nguyentanhuy698-maker/bai-giu-xe-thong-minh/docs/rap-cat-1-1-A4.pdf

## HƯỚNG DẪN DÙNG RẬP

In khổ A4, tỉ lệ 100 % (Actual size), tắt "Fit to page" / "Vừa trang"

Tờ 1/10

Rập 1:1 · Bãi giữ xe máy thông minh · ĐA2

## 50 mm

KIỂM TRA: khung bên phải dài đúng 50 mm →

Sai lệch quá 0,5 mm: in lại ở 100 %, tắt "Vừa trang"

Nét liền đậm: cắt · Chữ thập: tâm khoan (chấm dùi trước) · Nét gạch: chỉ đánh dấu, không cắt · Kích thước ghi bằng mm

## CÁC BƯỚC

1. In tất cả các tờ trên giấy A4 ở tỉ lệ 100 %. Đo khung kiểm tra ở góc dưới mỗi tờ: phải đúng
50 mm.
2. Cắt rời từng chi tiết, chừa khoảng 3 mm ngoài nét cắt.
3. Dán rập lên mặt mica còn giấy bảo vệ (hoặc lên Formex) bằng keo dán giấy dạng thỏi hoặc băng keo 2 mặt mỏng.
4. Chấm dùi vào tâm chữ thập rồi mới khoan: khoan mồi Ø2, sau đó khoan đúng đường kính ghi cạnh lỗ.
5. Lỗ khoét chữ nhật (có gạch chéo): khoan 4 góc Ø3, cắt theo cạnh bằng cưa lọng hoặc dao cắt mica, giũa tới nét.
6. Cắt mica: dùng dao rạch mica rạch 5–6 lần theo nét liền, bẻ trên mép bàn. Mica trong 2 mm rạch nhẹ tay hơn.
7. Nét gạch chỉ để đánh dấu vị trí dán linh kiện, decal: không cắt.
8. Bóc rập bằng cách bóc luôn lớp giấy bảo vệ mica. Với Formex, lau keo bằng khăn ẩm.
9. Chi tiết dài hơn tờ A4 được chia nhiều tờ: chồng các dấu ghép ⊕ cùng tên lên nhau rồi dán băng keo.

## DANH SÁCH TỜ RẬP

1 | Hướng dẫn, chi tiết cắt thẳng theo kích thước
2 | Chốt: vách P1, P2, P3, P4
3 | Chốt: kính K1, K2
4 | Chốt: mái, viền biển tên, đế, quầy
5 | Tủ barie VÀO + cần barie
6 | Tủ barie RA + cần barie
7 | Hộp camera và cột camera (2 bộ)
8 | Đảo phân làn – rập khoan và vị trí dán (nửa phía đường)
9 | Đảo phân làn – rập khoan và vị trí dán (nửa phía bãi)
10 | Đế: nắp thăm, lỗ mặt sau, rãnh sườn, lỗ cột đỡ cần

## CHI TIẾT CẮT THẲNG (không cần rập, cắt theo kích thước)

Chi tiết | Kích thước | SL | Vật liệu / ghi chú
Mặt đế | 560 × 450 | 1 | Formex 5
Đáy đế | 560 × 450 | 1 | MDF 3 (khoét nắp thăm: tờ 10)
Khung trước, sau | 560 × 40 | 2 | Formex 5 (khung sau khoét lỗ: tờ 10)
Khung trái, phải | 440 × 40 | 2 | Formex 5
Sườn | 440 × 40 | 2 | Formex 5 (rãnh dây: tờ 10)
Vỉa hè trái | 90 × 330 | 2 lớp | Formex 5 + 3
Vỉa hè phải | 70 × 330 | 2 lớp | Formex 5 + 3
Đảo phân làn | 100 × 330 | 3 lớp | Formex 5 (khoan theo tờ 8, 9)
Trụ góc chốt | 4 × 4 × 98 | 4 | nhôm hộp
Ống cột camera | Ø12 × 47 | 2 | ống nhôm
Que đỡ cần | Ø5 × 64 | 2 | inox

## CHỐT – VÁCH DƯỚI (mica xám 3 mm)

P3 và P4 giống nhau. Vẽ nhìn từ mặt ngoài.

Tờ 2/10

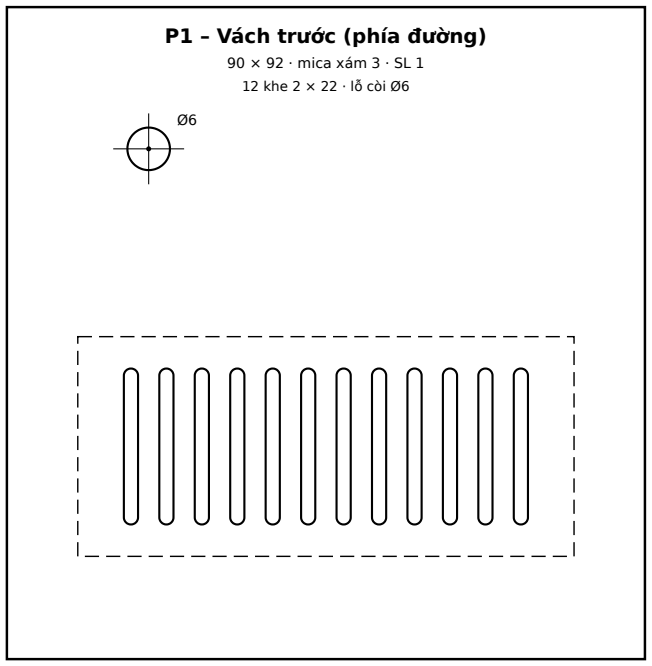
[picture p18: figure]
P1 – Vách trước (phía đường); 90 × 92 · mica xám 3 · SL 1 12 khe 2 × 22 · lỗ còi Ø6
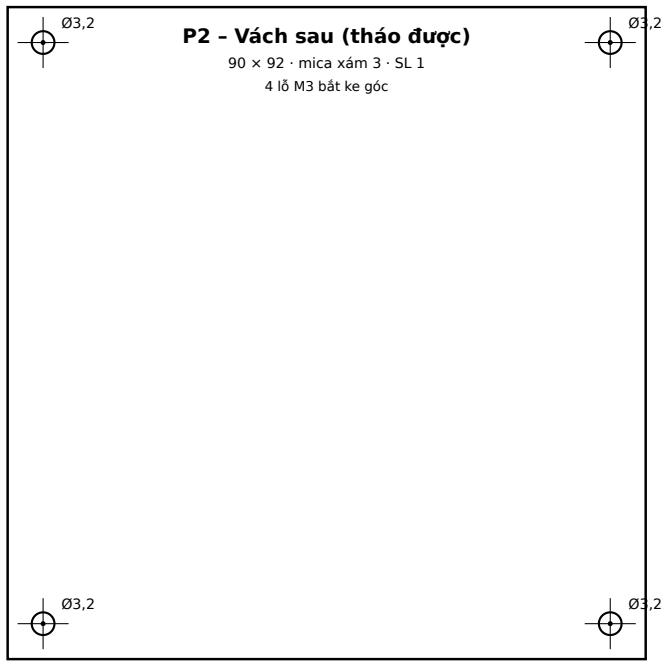
[picture p19: figure]
Ø3,2 P2 – Vách sau (tháo được); 90 × 92 · mica xám 3 · SL 1 4 lỗ M3 bắt ke góc
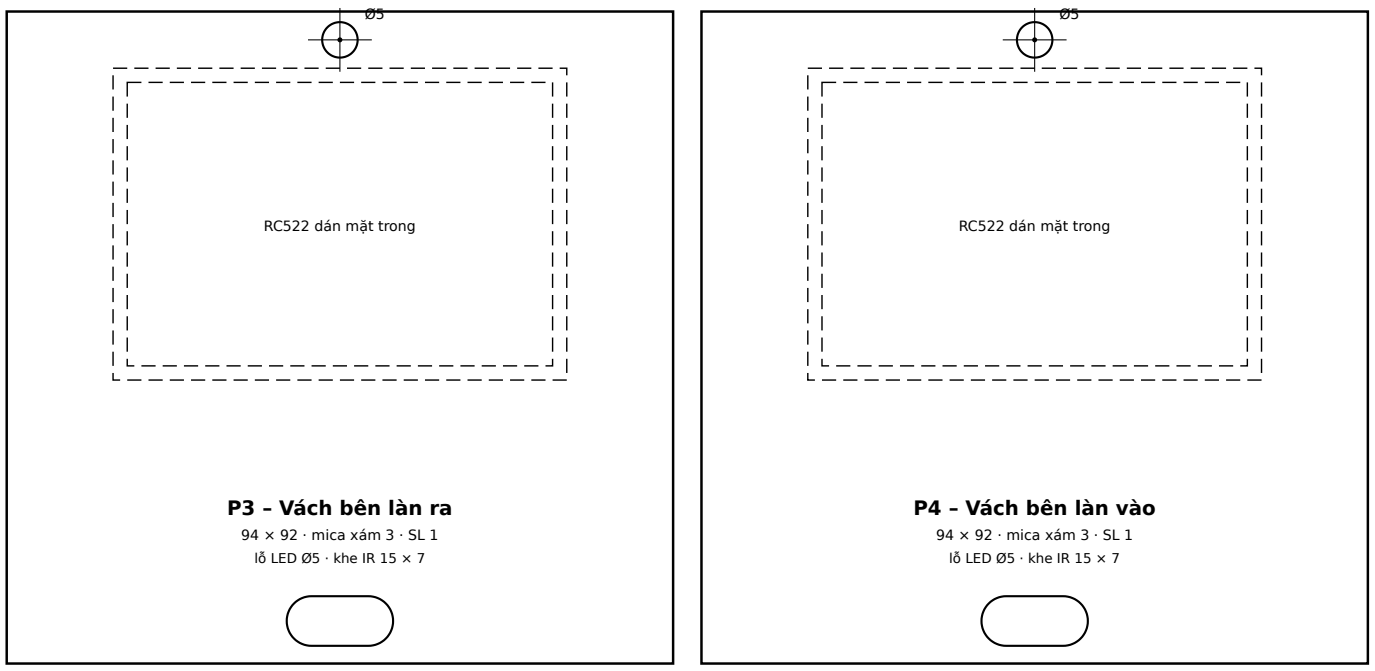
[picture p20: figure]
RC522 dán mặt trong; P3 – Vách bên làn ra; 94 × 92 · mica xám 3 · SL 1 lỗ LED Ø5 · khe IR 15 × 7; P4 – Vách bên làn vào

Mép dưới mỗi vách dán xuống đế chốt; P3, P4 kẹp giữa P1, P2 (chiều rộng 94 = 100 − 2 × 3).

Mặt quẹt thẻ: dán decal 64 × 44 lên mặt ngoài P3, P4 trùng khung nét gạch.

## CHỐT – KÍNH (mica trong 2 mm)

K1: kính trước và sau; K2: kính hai bên, chừa cửa đưa thẻ rộng 36

Tờ 3/10

K1 – Kính trước

82 × 94 · mica trong 2 · SL 1

K1 – Kính sau

82 × 94 · mica trong 2 · SL 1

K2 – Kính bên 1

28 × 94 · mica trong 2 · SL 1

K2 – Kính bên 2

28 × 94 · mica trong 2 · SL 1

K2 – Kính bên 3

28 × 94 · mica trong 2 · SL 1

K2 – Kính bên 4
28 × 94 · mica trong 2 · SL 1 | Ráp: mỗi vách bên dùng 2 tấm K2,
| cách nhau 36 (cửa đưa thẻ).
| K1, K2 dán vào 4 trụ nhôm 4 × 4.

## CHỐT – MÁI, VIỀN BIỂN TÊN, ĐẾ, QUẦY

Viền biển tên dán thành khung 108 × 118 quanh mái

Tờ 4/10

M – Mái

106 × 116 · mica xám 3 · SL 1

B1 16×118 SL 1

B1 – viền dài 118 × 16

B1 16×118 SL 1

B1 – viền dài 118 × 16

B2 16×102 SL 1

B2 – viền ngắn 102 × 16

B2 16×102 SL 1

B2 – viền ngắn 102 × 16

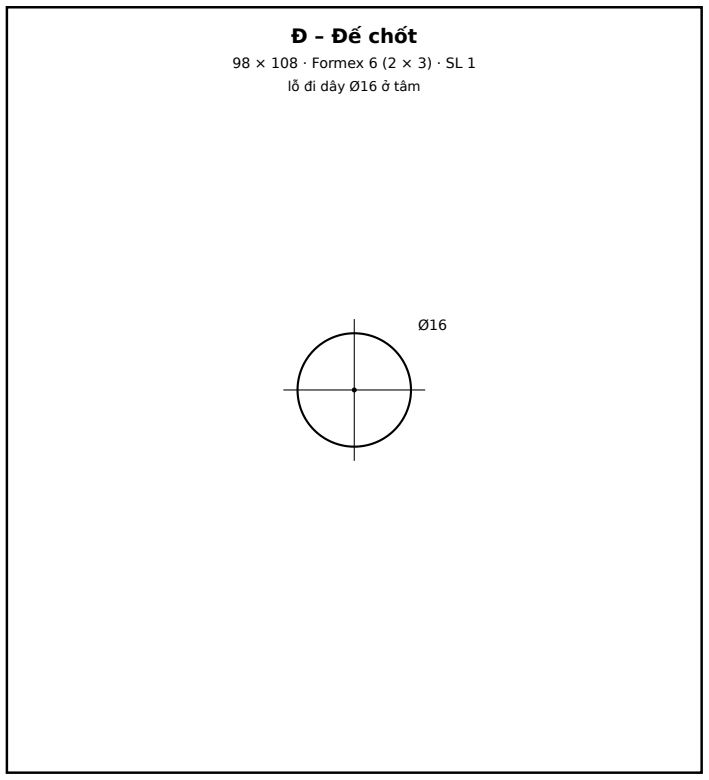
[picture p21: figure]
Đ – Đế chốt; 98 × 108 · Formex 6 (2 × 3) · SL 1 lỗ đi dây Ø16 ở tâm

Q 16×44 SL 1 | Q 16×44 SL 1

Q – Quầy 16 × 44 (2 tấm), dán ngang mép trên vách bên, giữa vách.

## TỦ BARIE VÀO + CẦN BARIE (mica vàng 3 mm, cần mica trắng 4 mm)

C1 nhìn từ mặt ngoài phía làn; đầu servo đẩy từ trong ra qua lỗ khoét

Tờ 5/10

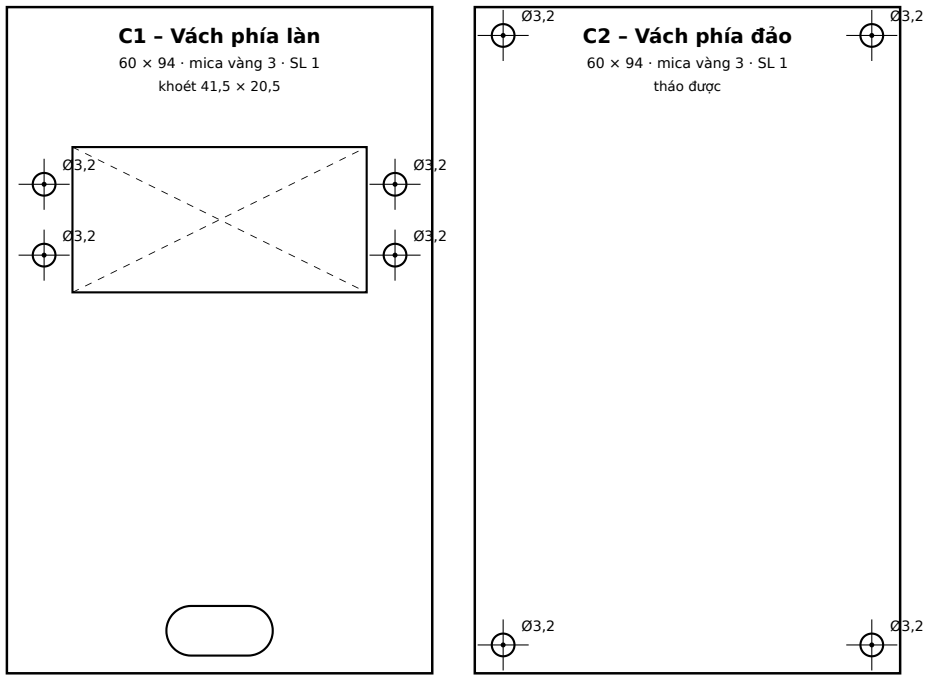
[picture p22: figure]
C1 – Vách phía làn; 60 × 94 · mica vàng 3 · SL 1 khoét 41,5 × 20,5; C2 – Vách phía đảo; 60 × 94 · mica vàng 3 · SL 1 tháo được

decal VÀO

C3 – Vách trước

44 × 94 · mica vàng 3 · SL 1

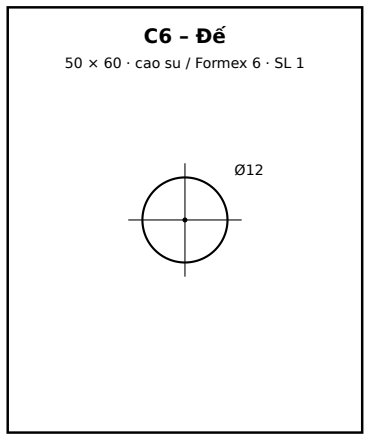
[picture p23: figure]
50 × 60 · cao su / Formex 6 · SL 1

C4 – Vách sau

44 × 94 · mica vàng 3 · SL 1

C5 – Nắp

54 × 64 · mica xám 3 · SL 1

CB – Cần barie 150 × 8 (mica trắng 4) · 2 lỗ Ø2,2 · khung gạch: decal đỏ 10 × 8

đầu cao su 8 × 10

Ngàm đỡ cần 8 × 9

rãnh 5 × 5, dày 10

## TỦ BARIE RA + CẦN BARIE (mica vàng 3 mm, cần mica trắng 4 mm)

C1 nhìn từ mặt ngoài phía làn; đầu servo đẩy từ trong ra qua lỗ khoét

Tờ 6/10

decal RA

C3 – Vách trước

44 × 94 · mica vàng 3 · SL 1

C4 – Vách sau

44 × 94 · mica vàng 3 · SL 1

C5 – Nắp

54 × 64 · mica xám 3 · SL 1

CB – Cần barie 150 × 8 (mica trắng 4) · 2 lỗ Ø2,2 · khung gạch: decal đỏ 10 × 8

đầu cao su 8 × 10

Ngàm đỡ cần 8 × 9

rãnh 5 × 5, dày 10

## HỘP CAMERA VÀ CỘT CAMERA – ĐỦ CHO 2 CỘT

Hộp: mica trắng 2 mm; H4 mica trong 2 mm; H5 mica xám 2 mm

Tờ 7/10

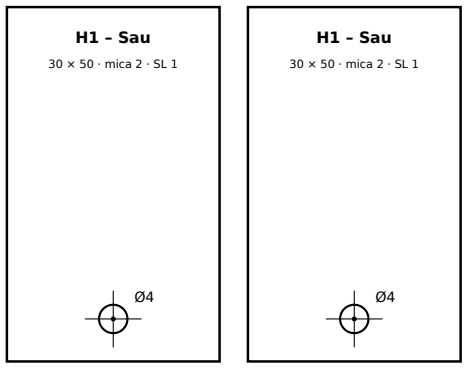
[picture p24: figure]
H1 – Sau; 30 × 50 · mica 2 · SL 1

H2 – Bên

28 × 50 · mica 2 · SL 1

H2 – Bên

28 × 50 · mica 2 · SL 1

H2 – Bên

28 × 50 · mica 2 · SL 1

H2 – Bên

28 × 50 · mica 2 · SL 1

H2: rãnh giữ bo ESP32-CAM sâu 1 (nét gạch) – khắc bằng dao, cách mép trước 6

Ø4

H3 – Đáy

30 × 26 · mica 2 · SL 1
Ø4

H3 – Đáy

30 × 26 · mica 2 · SL 1

H4 – Cửa sổ

30 × 46 · mica trong 2 · SL 1

H4 – Cửa sổ

30 × 46 · mica trong 2 · SL 1

H5 – Mái che

40 × 38 · mica xám 2 · SL 1

H5 – Mái che

40 × 38 · mica xám 2 · SL 1

Đ – Đế cột Ø20, lỗ Ø8 | Đ – Đế cột Ø20, lỗ Ø8
N 8 × 8 | N 8 × 8

N: mặt trên vát 15°

T – Tay đỡ đèn 30 × 4 × 4 (2 thanh)

THƯỚC ĐẶT GÓC CAMERA (cắt rời, đặt sát mép đảo khi dán cột)

35,8°

mép đảo, chiều xe chạy ↑

hướng ống kính

15°

phương ngang

trục ống kính chúc xuống

## ĐẢO PHÂN LÀN 100 × 330 – TỜ 1/2 (nửa phía đường)

Dán lên lớp đảo trên cùng, khoan xuyên 3 lớp đảo và mặt đế. Nét gạch: chỗ dán chốt, tủ, cột.

Tờ 8/10

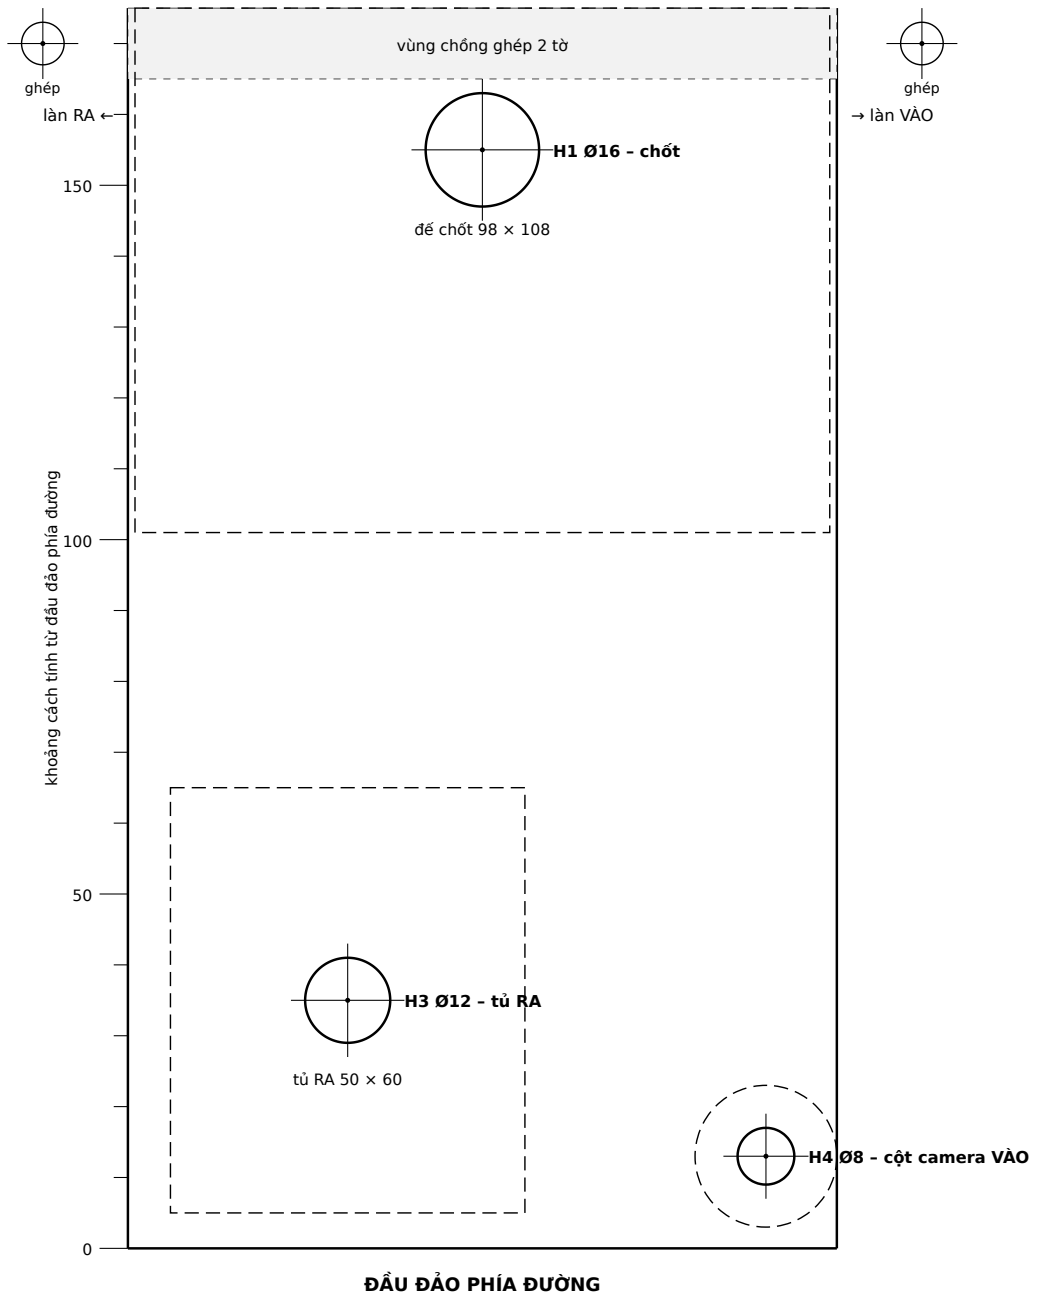
[picture p25: figure]
vùng chồng ghép 2 tờ; ghép; đế chốt 98 × 108; H1 Ø16 – chốt; H4 Ø8 – cột camera VÀO; khoảng cách tính từ đầu đảo phía đường; ĐẦU ĐẢO PHÍA ĐƯỜNG; làn RA ←; → làn VÀO

Đặt đảo lên mặt đế: mép trái cách mép đế 240, đầu đảo cách mép đế phía đường 60

## ĐẢO PHÂN LÀN 100 × 330 – TỜ 2/2 (nửa phía bãi)

Dán lên lớp đảo trên cùng, khoan xuyên 3 lớp đảo và mặt đế. Nét gạch: chỗ dán chốt, tủ, cột.

Tờ 9/10

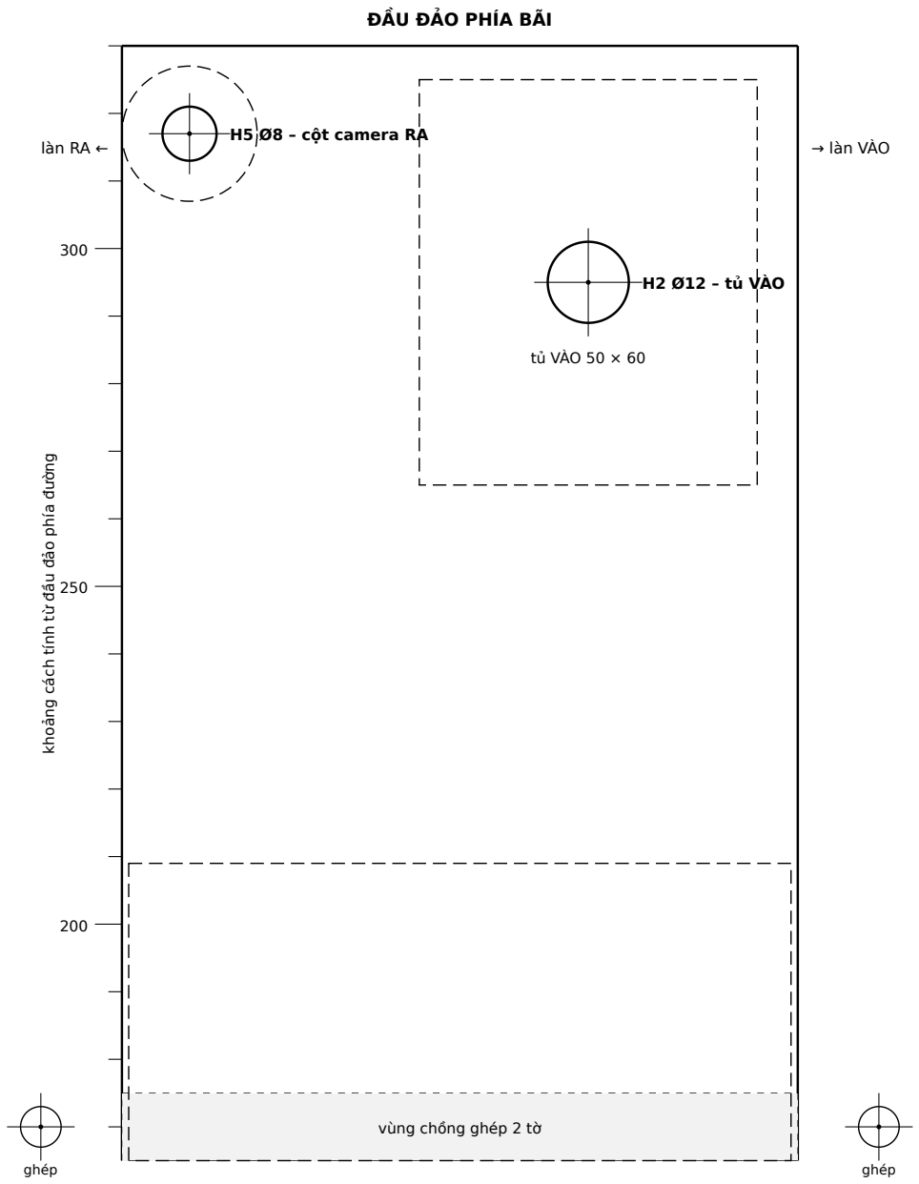
[picture p26: figure]
vùng chồng ghép 2 tờ; ghép; tủ VÀO 50 × 60; H2 Ø12 – tủ VÀO; H5 Ø8 – cột camera RA; khoảng cách tính từ đầu đảo phía đường; ĐẦU ĐẢO PHÍA BÃI; làn RA ←; → làn VÀO

ĐẾ – NẮP THĂM, LỖ MẶT SAU, RÃNH SƯỜN, LỖ CỘT ĐỠ CẦN | Tờ 10/10

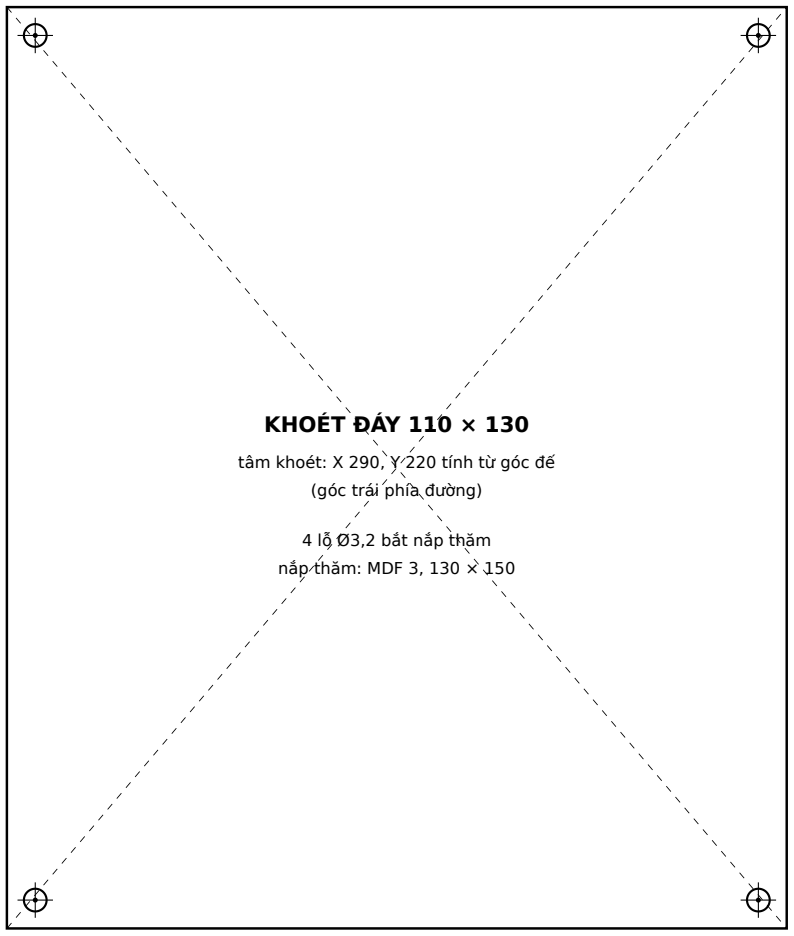
[picture p27: figure]
KHOÉT ĐÁY 110 × 130; tâm khoét: X 290, Y 220 tính từ góc đế; (góc trái phía đường); 4 lỗ Ø3,2 bắt nắp thăm; nắp thăm: MDF 3, 130 × 150
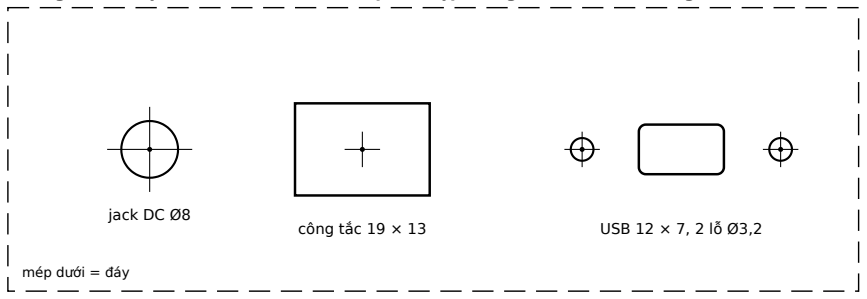
[picture p28: figure]
jack DC Ø8; công tắc 19 × 13; USB 12 × 7, 2 lỗ Ø3,2; mép dưới = đáy

Khung sau – đoạn có lỗ (dán sao cho mép trái rập trùng X = 120 của khung sau)

Rãnh dây trên sườn (4 chỗ)

khoét 24 × 15

đoạn sườn cao 40

Tâm rãnh tại Y = 120 và Y = 330 (tính từ mép đế phía đường)

Vỉa hè PHẢI – cột đỡ cần VÀO

mép vỉa hè giáp làn = cạnh trái
tâm cách cạnh 5, cách đầu phía đường 305

Ø5 sâu 8

Vỉa hè TRÁI – cột đỡ cần RA

cạnh phải giáp làn, cạnh dưới phía đường tâm cách cạnh phải 5, cách cạnh dưới 25

Ø5 sâu 8
