nguyentanhuy698-maker/bai-giu-xe-thong-minh/tools/ban-ve/img_persp.png

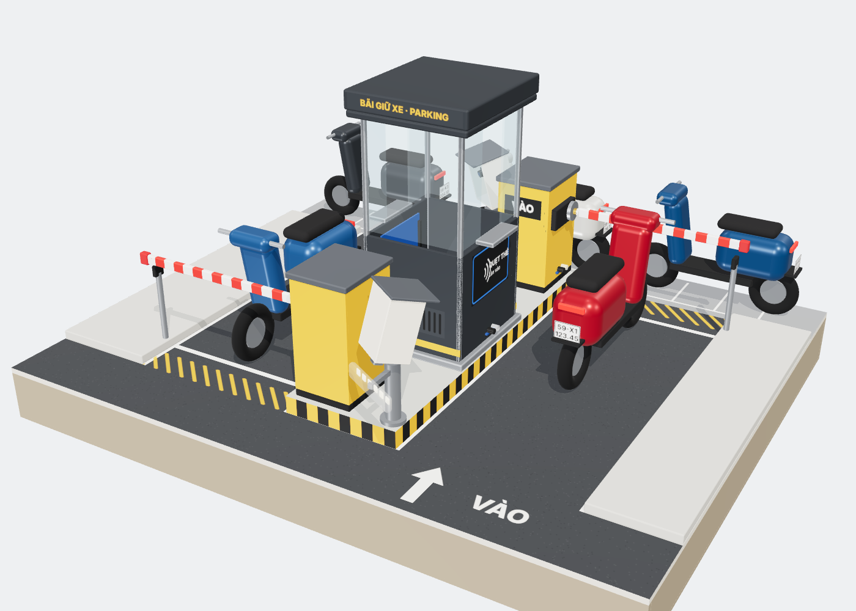
tools/ban-ve/img_persp.png
