nguyentanhuy698-maker/bai-giu-xe-thong-minh/(commit log)

2026-11-10 Thêm trang mô phỏng bãi giữ xe và phối cảnh 3D
    Claude-Session: https://claude.ai/code/session_01Y5WDavQozfoccEv6DFBwDj
2026-11-10 Thiết kế lại giao diện trang mô phỏng
    Bảng điều khiển kiểu chốt bảo vệ, sơ đồ 50 chỗ đỗ, thanh tiến trình từng bước cho mỗi làn, phím tắt V/R/T/A, bố cục cho điện thoại.
    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
2026-11-11 Thêm mô phỏng Wokwi cho trụ điều khiển 2 làn
    Firmware ESP32 dạng máy trạng thái (không dùng delay), giao tiếp MQTT, cảm biến IR an toàn, an toàn khi mất mạng; kèm server giả lập Python.
    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
2026-11-11 Chốt nhân viên ở đảo giữa: quẹt thẻ và thu phí
    Thay trụ điều khiển bằng chốt nhân viên giữa 2 làn, nhân viên với tay quẹt thẻ, màn hình cho khách hiện phí và mã QR, thanh toán tiền mặt hoặc QR trước khi mở barie ở làn ra.
    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
2026-11-11 Thêm trang quản lý bãi xe
    Tổng quan, xe trong bãi và tra cứu mất thẻ, lịch sử, thống kê ngày/tuần/tháng/quý kèm xuất Excel, thẻ tháng, cảnh báo, cài đặt. Trang mô phỏng lưu sự kiện để trang quản lý đọc.
    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
2026-11-11 Them muc May giu xe: man hinh lam viec o chot (thong ke, camera, anh chup, thong tin luot), noi phan cung qua MQTT WebSocket; server_mock dung chung topic va gui them thong tin; firmware nhan lenh mo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
2026-11-11 Trang mo phong ghi su kien theo gio that (thoi gian gui van theo dong ho mo phong) va nhip tim theo gio that, de trang quan ly tinh dung ca truc va doanh thu ca
    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
2026-11-11 Báo cáo kiểm thử và đánh giá mới (126 tình huống), sửa lỗi mô phỏng và đăng nhập
    - Thay docs/bao-cao-kiem-thu.pdf: đánh giá giao diện, nghiệp vụ, thiết kế hệ thống,
    lỗi đã sửa, hạn chế, đề xuất; 126 tình huống kèm ảnh chụp
    - Mô phỏng: giờ vào thật cố định cho mỗi xe để khóa lượt ổn định
    - Đăng nhập cùng tài khoản ở thẻ khác không còn đăng xuất lồng nhau
    - Chỉ vẽ lại Tổng quan/Thiết bị khi bộ đếm IR đổi
    - Máy giữ xe ghim cảnh báo đánh tráo chưa xử lý ở làn ra
    Claude-Session: https://cla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
2026-11-12 Firmware phần cứng thật cho trụ điều khiển; sửa bộ đệm MQTT làm ESP32 bỏ lệnh của server
    - firmware/tru_dieu_khien: 2 RC522 chung SPI, 2 servo, IR xe tới + IR an toàn, DFPlayer, còi,
    WS2812; lệnh Serial để thử từng khối; tự kiểm tra RC522 và DFPlayer lúc khởi động
    - firmware/am_thanh/tao_am_thanh.py tạo 5 câu loa tiếng Việt; firmware/mosquitto/mosquitto.conf
    - wokwi/sketch.ino: setBufferSize(512). Lệnh của server dài 240–280 byte, vượt 256 byte
    mặc định của PubSubClient nên ESP32 bỏ lệnh và báo hết giờ chờ server
    - server_mock.py: ghi log topic arrive; chạy nền không có bàn phím vẫn tiếp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
2026-11-12 Bỏ __pycache__ khỏi repo
    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
2026-11-12 Phối cảnh lắp ráp từ linh kiện thật; còi dùng module 3 chân kích mức thấp
    - lap-rap-3d.html: mô hình 1:10, linh kiện vẽ đúng kích thước thật (ESP32, ESP32-CAM,
    RC522, MG996R, FC-51, DFPlayer, loa, còi, đèn LED, mạch hạ áp, PCB đục lỗ); góc nhìn
    xuyên vỏ cho chốt, tủ barie, cột camera, khoang điện dưới đế; đường dây theo màu;
    hình chiếu đứng, bằng có kích thước; bảng linh kiện bấm để xem vị trí
    - Dời tủ barie ra z = ±130 và cột camera ra mép đảo để camera nhìn biển số sau lệch 36°
    (vị trí cũ nhìn gần như vuông góc với biển)
    - Firmware: BUZZER_ACTIVE_L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
    [tru_dieu_khien.ino]
2026-11-12 Hình chiếu đứng: ẩn xe để thấy rõ kích thước
    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
2026-11-12 Bản vẽ kỹ thuật lắp ráp 11 tờ A3 theo TCVN; căn giữa servo trong tủ barie
    - docs/ban-ve-ky-thuat.pdf: BV-01 lắp chung 1:5, BV-02 mặt bằng toạ độ 1:2, BV-03 đế và
    khoang điện, BV-04 chốt, BV-05 khai triển mica chốt 1:1, BV-06 tủ barie và cần, BV-07 cột
    và hộp camera, BV-08 bo mạch 2:1, BV-09 sơ đồ nối dây, BV-10 kích thước chuẩn linh kiện
    (có nguồn tra cứu), BV-11 vật tư phụ, ngân sách nguồn, quy trình lắp ráp và kiểm tra
    - tools/ban-ve: mã Python sinh bản vẽ (SVG → PDF)
    - Phối cảnh 3D: servo đặt giữa tủ, trục barie dời 10,3 mm cho khớp bản vẽ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
2026-11-12 tools/ban-ve: đường dẫn tương đối, chạy được từ repo
    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
2026-11-12 Thêm rập cắt 1:1 khổ A4; sửa kích thước viền biển tên trên BV-05
    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
2026-11-12 Firmware ESP32-CAM, script thử camera, quy trình test sau lắp ráp; giữ chân RST chung của 2 RC522 ở mức HIGH
    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
2026-11-12 Máy chủ nhận dạng biển số thật (server/), trang quản lý hiện ảnh thật từ ESP32-CAM, bỏ camera người lái cho khớp phần cứng
    - server/nhan_dang.py: tìm vùng biển số (OpenCV hoặc YOLO nếu có), bỏ khung, tách 2 dòng, EasyOCR/Tesseract, sửa ký tự dễ nhầm theo vị trí, bỏ phiếu nhiều ảnh, giới hạn 3 s
    - server/may_chu.py: cùng topic với server_mock; chụp sẵn khi IR thấy xe (dùng 1 lần), lưu ảnh và xe trong bãi, so biển lúc ra
    - quan-ly.html: ảnh thật lúc quẹt thẻ, xem trực tiếp stream camera, thống kê nhận dạng dùng số đo thật
    - camera_bien_so.ino: ép kiểu size_t trong printf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
2026-11-12 Áp dụng bộ nhận diện Moto-Chan cho các trang web và mô hình 3D
    - assets/brand/: logo, icon, favicon, hướng dẫn thương hiệu
    - quan-ly.html, index.html: màu teal/navy/cam, font Nunito + Be Vietnam Pro, logo ở thanh bên và màn đăng nhập, nút chính teal, sọc cam–trắng
    - phoi-canh-3d.html, lap-rap-3d.html: thanh tiêu đề có logo, nút đang chọn màu Mist
    - Mô hình 3D: biển tên chốt MOTO-CHAN nền teal, cần barie sọc cam–trắng
    - Bộ kiểm thử trang quản lý chạy lại đều đạt
    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
